valsted/Flipper/report/sections/cuts.tex

\label{appendix:cuts}
This section contains reprensentation of the cuts necessary for the entire machine. See figure \ref{fig:cut01}, \ref{fig:cut02} and \ref{fig:cut03} for these representations. Please see the submitted .PDF files for the actual cutting files appropriate for a laser cutter. 
\begin{figure*}
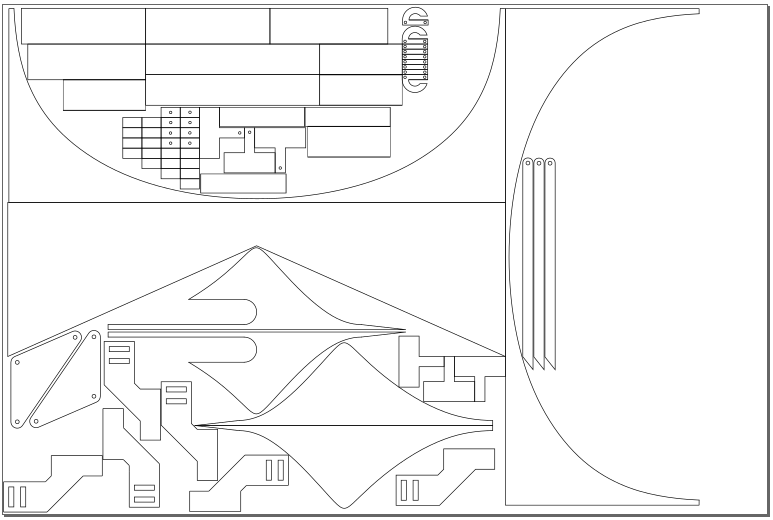
[picture p19: report/img/Cut01.PNG]
	
	\caption{This cut contains brackets and bodywork for the entire machine.}
	\label{fig:cut01}
\end{figure*}
\begin{figure*}
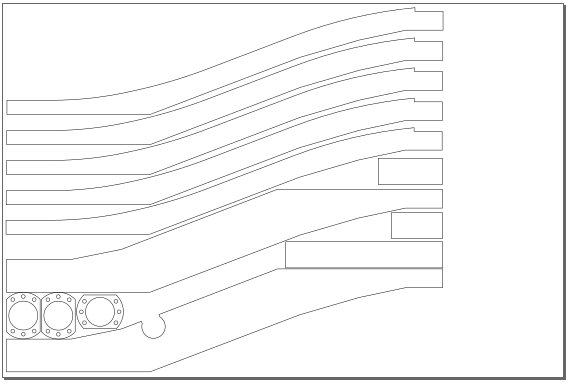
[picture p20: report/img/Cut02.PNG]
	
	\caption{This cut contains the cuts neccessary for the ball-return slide}
	\label{fig:cut02}
\end{figure*}
\begin{figure*}
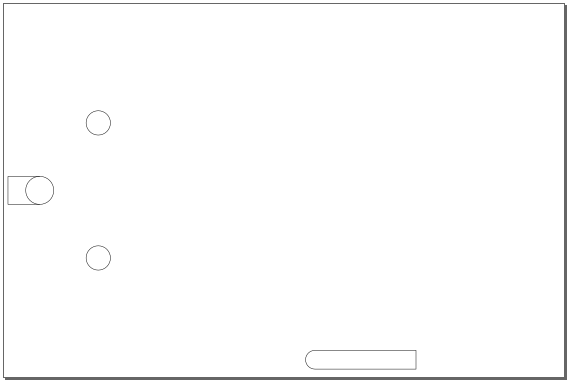
[picture p21: report/img/Cut03.PNG]
	
	\caption{This cut represents the holes neccesary for the playfield. Essentially when cut, the whole board becomes the playfield.}
	\label{fig:cut03}
\end{figure*}
