valsted/Flipper/report/sections/funcdiag.tex

Figure \ref{fig:funcdiag} provides an overview of the functional components making up the pinball-machine.
\begin{figure*}
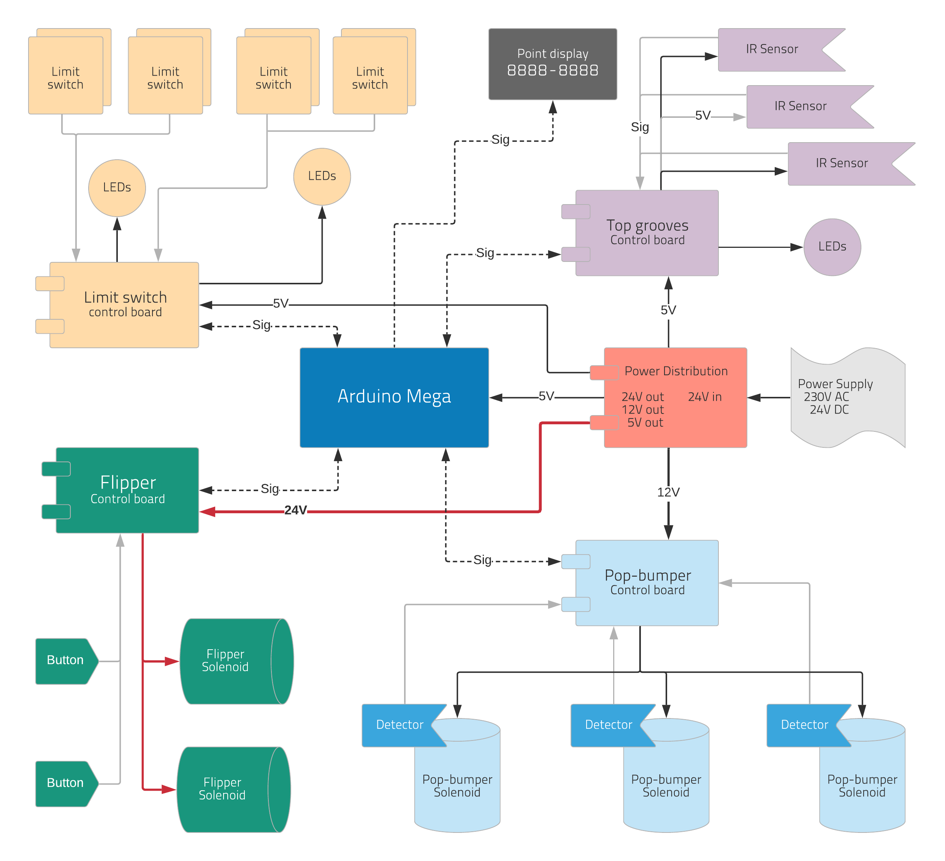
[picture p22: report/img/functional_diagram.png]
	
	\caption{Overview of the main electrical components in the pinball-machine.}
	\label{fig:funcdiag}
\end{figure*}
